bgkendall/Alufo/README.md

# Alufo

Small split keyboard using stacked one-layer aluminium core boards with an on-board CH552T controller.
