bgkendall/Alufo/Middle Layer/Alufo Middle Layer Left.stl

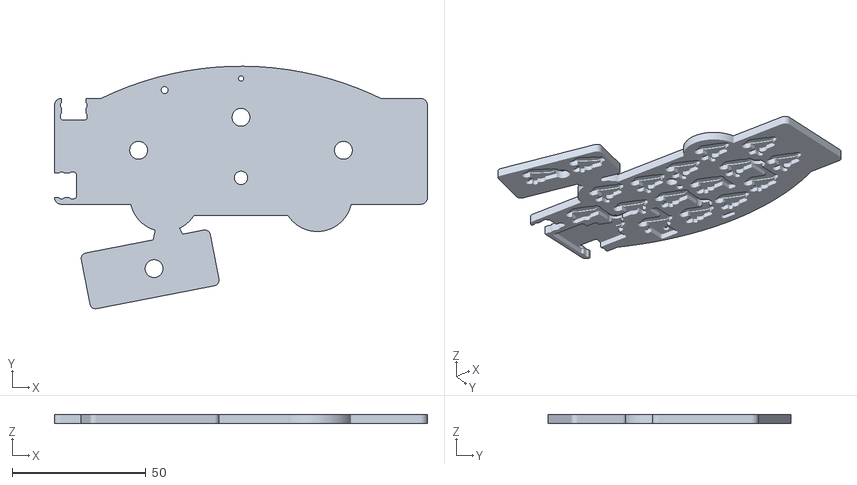
[picture p1: CAD file, 2024-11-10]
Middle Layer/Alufo Middle Layer Left.stl
139.7 x 90.9 x 3.50
