bgkendall/Alufo/(list of files, cad)

Other CAD files:
Middle Layer/Alufo Middle Layer Right.stl
