bgkendall/Alufo/PCB Left/Alufo.kicad_pcb

## KiCad design PCB Left/Alufo.kicad_pcb (2025-04-01)

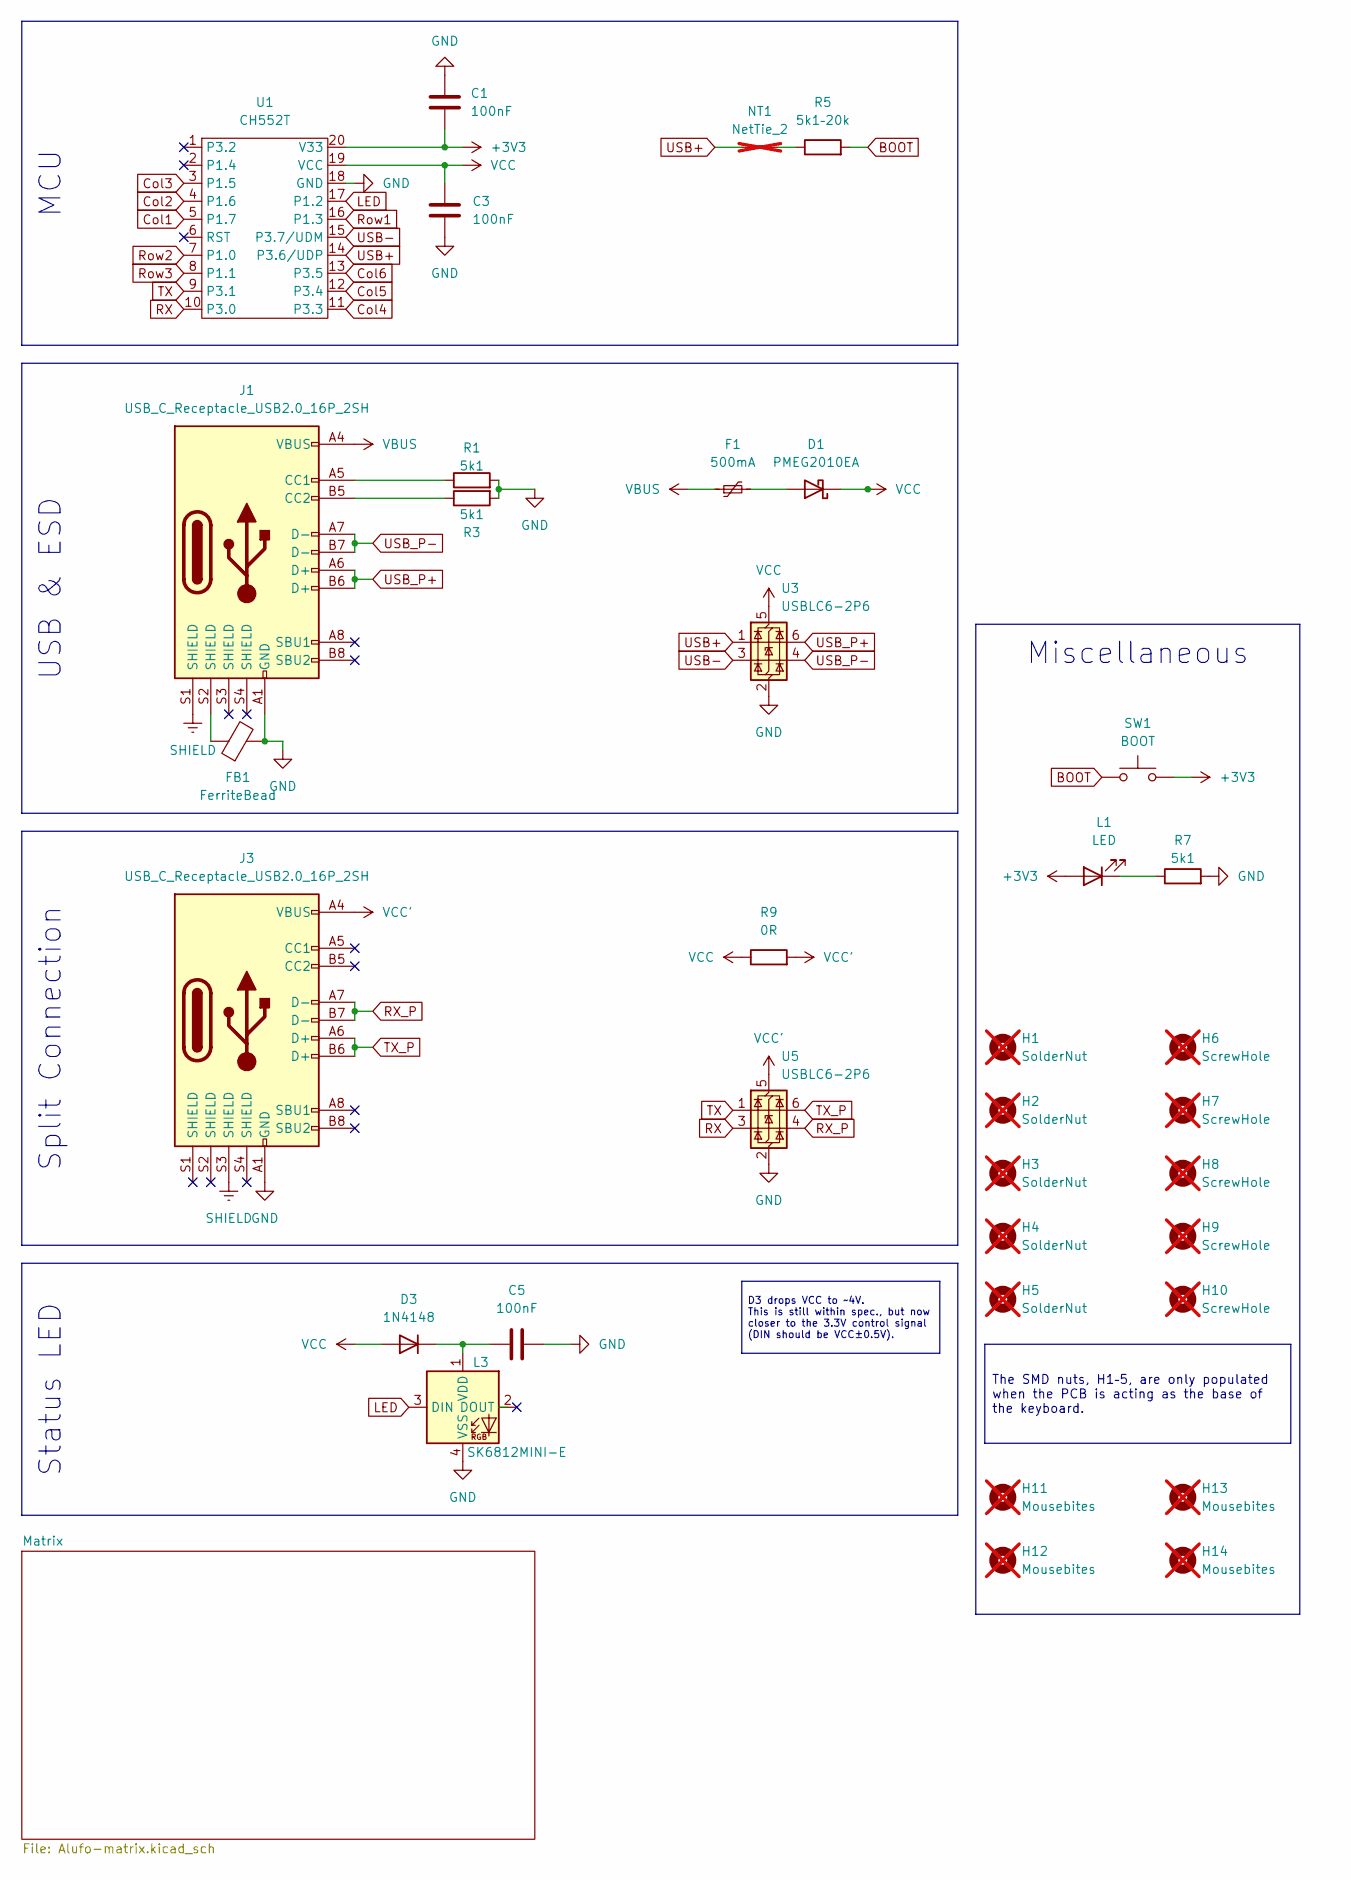
[picture p2: schematic Alufo.kicad_sch, Alufo]

Parts:
C1, C3, C5: 100nF; C_0603_1608Metric; LCSC C66501
D1: PMEG2010EA; D_SOD-323; LCSC C193668
D3: 1N4148; D_SOD-123; LCSC C917030
F1: 500mA; Fuse_0603_1608Metric; LCSC C210357
FB1: FerriteBead; L_0805_2012Metric; LCSC C20416196
H1, H2, H3, H4, H5: SolderNut; MountingHole_2.2mm_M2_SMD_Solder_Nut; not fitted
H6, H7, H8, H9, H10: ScrewHole; MountingHole_2.2mm_M2; not fitted
H11, H12, H13, H14: Mousebites; not fitted
J1, J3: USB_C_Receptacle_USB2.0_16P_2SH; USB_C_Receptacle_GCT_USB4110; LCSC C5143397
L1: LED; LED_0805_2012Metric_Mod; LCSC C965818
L3: SK6812MINI-E; LED_6028R; LCSC C5149201
NT1: NetTie_2; NetTie-2_SMD_Pad0.2mm; not fitted
R1, R3, R7: 5k1; R_0603_1608Metric; LCSC C23186
R5: 5k1–20k; R_0603_1608Metric; LCSC C25804
R9: 0R; R_2010_5025Metric; LCSC C2960848
SW1: BOOT; SW_SPST_SKQG_WithStem; LCSC C115351
U1: CH552T; TSSOP-20_4.4x6.5mm_P0.65mm; LCSC C111367
U3, U5: USBLC6-2P6; SOT-666_Mod; LCSC C3647099

Connections:
+3V3: C1.1, L1.2 (A), SW1.2, U1.20 (V33)
BOOT: R5.2, SW1.1
Col1: U1.5 (P1.7); also elsewhere on the board
Col2: U1.4 (P1.6); also elsewhere on the board
Col3: U1.3 (P1.5); also elsewhere on the board
Col4: U1.11 (P3.3); also elsewhere on the board
Col5: U1.12 (P3.4); also elsewhere on the board
Col6: U1.13 (P3.5); also elsewhere on the board
GND: C1.2, C3.2, C5.2, FB1.2, J1.A1 (GND), J1.A12 (GND), J1.B1 (GND), J1.B12 (GND), J3.A1 (GND), J3.A12 (GND), J3.B1 (GND), J3.B12 (GND), L3.4 (VSS), R1.2, R3.2, R7.2, U1.18 (GND), U3.2 (GND), U5.2 (GND)
LED: L3.3 (DIN), U1.17 (P1.2)
unnamed: D1.2 (A), F1.2
unnamed: C5.1, D3.1 (K), L3.1 (VDD)
unnamed: FB1.1, J1.S2 (SHIELD)
unnamed: J1.A5 (CC1), R1.1
unnamed: J1.B5 (CC2), R3.1
unnamed: L1.1 (K), R7.1
unnamed: NT1.2, R5.1
RX: U1.10 (P3.0), U5.3 (I/O2)
RX_P: J3.A7 (D-), J3.B7 (D-), U5.4 (I/O2)
Row1: U1.16 (P1.3); also elsewhere on the board
Row2: U1.7 (P1.0); also elsewhere on the board
Row3: U1.8 (P1.1); also elsewhere on the board
SHIELD: J1.S1 (SHIELD), J3.S3 (SHIELD)
TX: U1.9 (P3.1), U5.1 (I/O1)
TX_P: J3.A6 (D+), J3.B6 (D+), U5.6 (I/O1)
USB+: NT1.1, U1.14 (P3.6/UDP), U3.1 (I/O1)
USB-: U1.15 (P3.7/UDM), U3.3 (I/O2)
USB_P+: J1.A6 (D+), J1.B6 (D+), U3.6 (I/O1)
USB_P-: J1.A7 (D-), J1.B7 (D-), U3.4 (I/O2)
VBUS: F1.1, J1.A4 (VBUS), J1.A9 (VBUS), J1.B4 (VBUS), J1.B9 (VBUS)
VCC: C3.1, D1.1 (K), D3.2 (A), R9.1, U1.19 (VCC), U3.5 (VBUS)
VCC': J3.A4 (VBUS), J3.A9 (VBUS), J3.B4 (VBUS), J3.B9 (VBUS), R9.2, U5.5 (VBUS)

Notes on the sheet:
MCU
Miscellaneous
The SMD nuts, H1–5, are only populated when the PCB is acting as the base of the keyboard.
Split Connection
USB & ESD
D3 drops VCC to ~4V. This is still within spec., but now closer to the 3.3V control signal (DIN should be VCC±0.5V).
Status LED

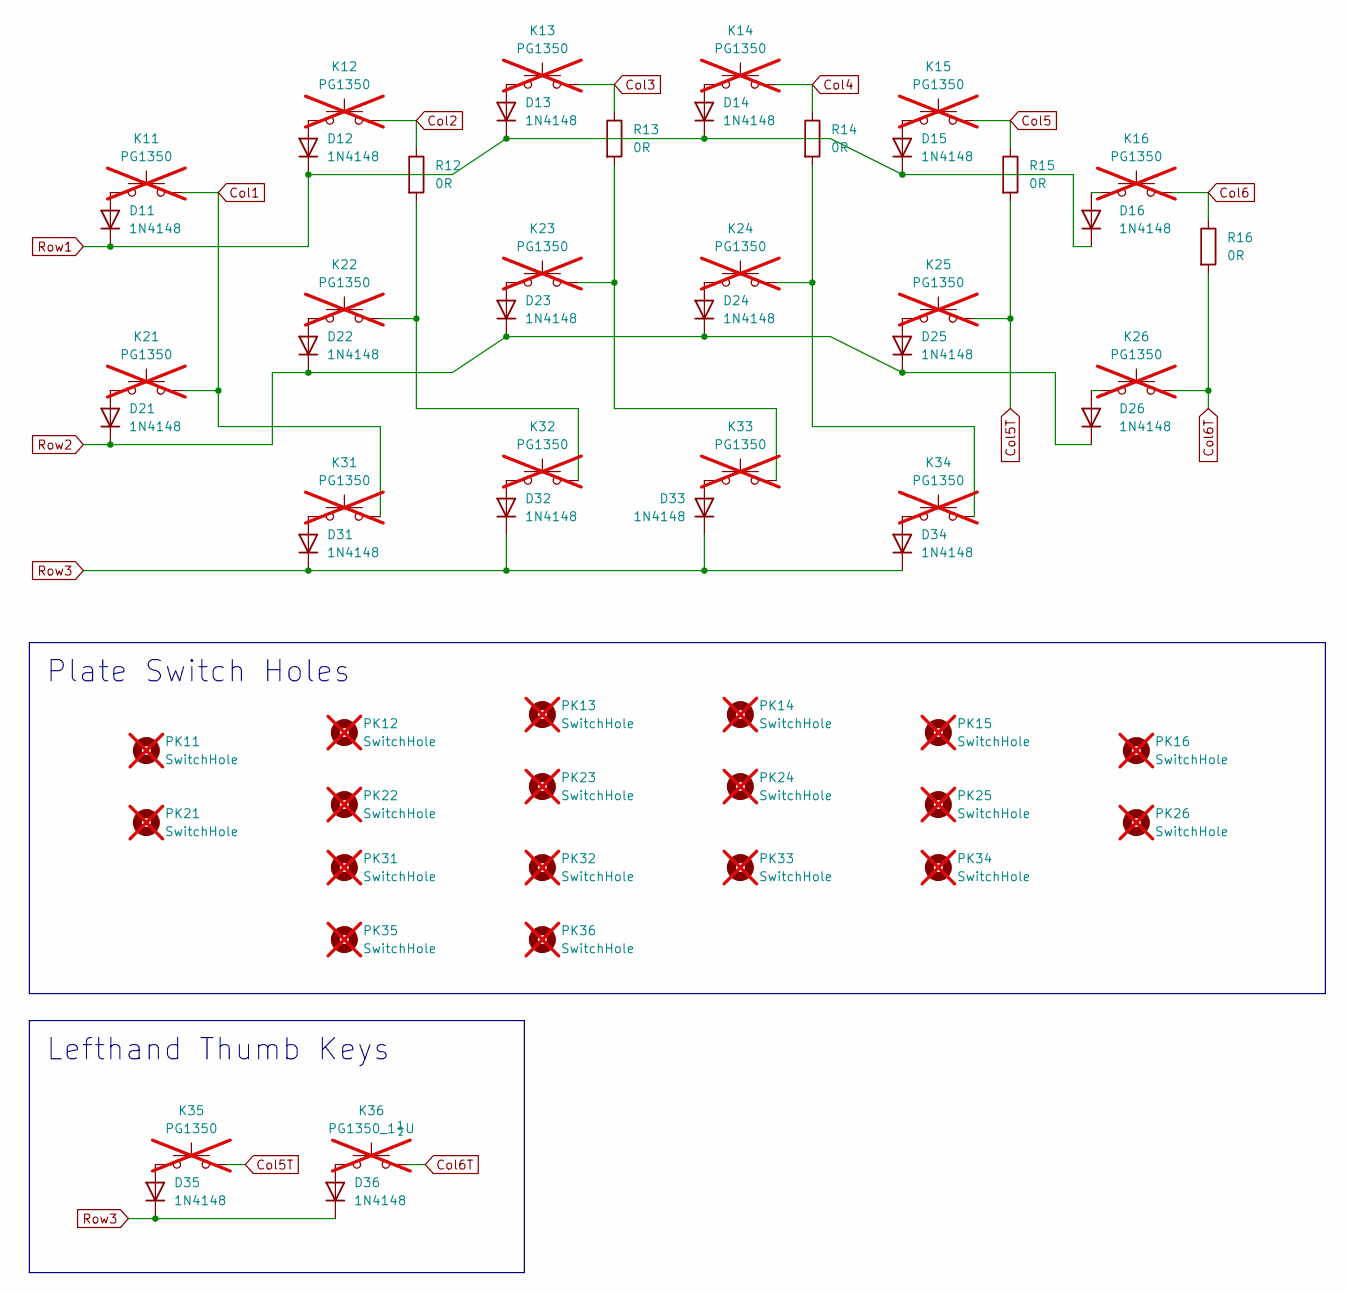
[picture p3: schematic Alufo-matrix.kicad_sch, Alufo]

Parts:
D11, D12, D13, D14, D15, D16, D21, D22, D23, D24, D25, D26, D31, D32, D33, D34, D35, D36: 1N4148; D_SOD-123_Mod; LCSC C917030
K11, K12, K13, K14, K15, K16, K21, K22, K23, K24, K25, K26, K31, K32, K33, K34, K35: PG1350; SW_choc_v1_HS_CPG135001S30_1layer_1u; LCSC C5333465; not fitted
K36: PG1350_1½U; SW_choc_v1_HS_CPG135001S30_1layer_1.5u; LCSC C5333465; not fitted
PK11, PK12, PK13, PK14, PK15, PK16, PK21, PK22, PK23, PK24, PK25, PK26, PK31, PK32, PK33, PK34, PK35: SwitchHole; SW_choc_v1_Plate_CPG135001S30_1u; not fitted
PK36: SwitchHole; SW_choc_v1_Plate_CPG135001S30_1.5u; not fitted
R12, R13, R14, R15, R16: 0R; R_2010_5025Metric; LCSC C2960848

Connections:
Col1: K11.1, K21.1, K31.1; also elsewhere on the board
Col2: K12.1, R12.1; also elsewhere on the board
Col3: K13.1, R13.1; also elsewhere on the board
Col4: K14.1, R14.1; also elsewhere on the board
Col5: K15.1, R15.1; also elsewhere on the board
Col5T: K25.1, K35.1, R15.2
Col6: K16.1, R16.1; also elsewhere on the board
Col6T: K26.1, K36.1, R16.2
unnamed: D11.2 (A), K11.2
unnamed: D12.2 (A), K12.2
unnamed: D13.2 (A), K13.2
unnamed: D14.2 (A), K14.2
unnamed: D15.2 (A), K15.2
unnamed: D16.2 (A), K16.2
unnamed: D21.2 (A), K21.2
unnamed: D22.2 (A), K22.2
unnamed: D23.2 (A), K23.2
unnamed: D24.2 (A), K24.2
unnamed: D25.2 (A), K25.2
unnamed: D26.2 (A), K26.2
unnamed: D31.2 (A), K31.2
unnamed: D32.2 (A), K32.2
unnamed: D33.2 (A), K33.2
unnamed: D34.2 (A), K34.2
unnamed: D35.2 (A), K35.2
unnamed: D36.2 (A), K36.2
unnamed: K22.1, K32.1, R12.2
unnamed: K23.1, K33.1, R13.2
unnamed: K24.1, K34.1, R14.2
Row1: D11.1 (K), D12.1 (K), D13.1 (K), D14.1 (K), D15.1 (K), D16.1 (K); also elsewhere on the board
Row2: D21.1 (K), D22.1 (K), D23.1 (K), D24.1 (K), D25.1 (K), D26.1 (K); also elsewhere on the board
Row3: D31.1 (K), D32.1 (K), D33.1 (K), D34.1 (K), D35.1 (K), D36.1 (K); also elsewhere on the board

Notes on the sheet:
Lefthand Thumb Keys
Plate Switch Holes

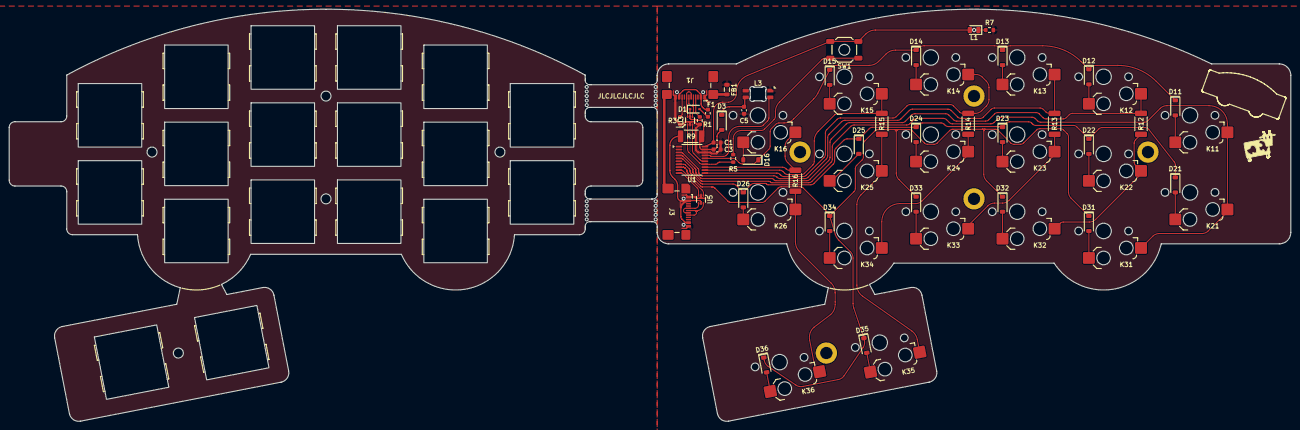
[picture p4: board Alufo.kicad_pcb from above]

Board: 2 copper layers, 282.6 x 90.9 mm, 94 parts (0 on the bottom side), 55 nets.
