bgkendall/Alufo/(commit log)

2024-07-21 Add initial version
    Very rough routing of matrix
    No USB ports, etc.
    [alumirror.kicad_pcb, alumirror.kicad_sch]
2024-07-21 Add possible deboss area for 3D print to switches
    Move top row diodes within this area
    Remove copper layers from switch pin holes
    [alumirror.kicad_pcb]
2024-07-21 Add 3D model pocket areas for all matrix components
    User 1–4 layers of switches, diodes and resistors now contain areas that will be excluded from the 3D print for the bottom-mid case. This will allow space for these components. These areas are constructed from shapes (e.g., the diode has two circles with a connecting rectangle) rather than lines. This is so that they can be imported straight into FreeCAD. Using arcs and lines would look cleaner, but the exported SVG files would need to be modified in design software to merge each group of lines into a single shape before import into FreeCAD.
    [alumirror.kicad_pcb, alumirror.kicad_sch]
2024-07-21 Tighten diode pocket
    [alumirror.kicad_pcb]
2024-07-22 Tweak edge cuts
    Also add keycap outlines to back silkscreen so they can be seen when viewing the 3D board model.
    [alumirror.kicad_pcb]
2024-07-22 Re-work thumb key connections
    The lefthand thumb keys are now on row 2, columns 0 and 5. This frees up a pin for potential red, green *and blue* LEDs.
    The righthand thumb keys remain on their own row. This is easier to route and allows for a 5-way navigation switch to be added.
    [alumirror.kicad_pcb, alumirror.kicad_sch]
2024-07-25 Add nav. switch proof-of-concept
    [alumirror.kicad_pcb, alumirror.kicad_sch]
2024-07-27 Add 3D model for SKQUAAA010
    The board actually uses a SKQUCAA010, but this is close enough
    Model from https://www.snapeda.com/parts/SKQUAAA010/ALPS/view-part/
    [alumirror.kicad_pcb]
2024-07-27 Renumber switches and diode by row and column
    [alumirror.kicad_pcb, alumirror.kicad_sch]
2024-07-27 Create combined choc/nav. switch footprint and use for SW31
    [alumirror.kicad_pcb, alumirror.kicad_sch]
2024-07-27 Add missing middle case layer cutout section for switches
2024-07-27 Flop board
    Switches now go in the correct column order (right to left when viewed from the copper side of the PCB) and the navigation switch is on the right thumb.
    [alumirror.kicad_pcb, alumirror.kicad_sch]
2024-07-27 Switch to SKQUAAA010 3D model that is not in lurid colours
    Model from https://componentsearchengine.com/part-view/SKQUAAA010/ALPS%20Electric
    [alumirror.kicad_pcb]
2024-07-27 Move bottom row one column over
    This allows the left thumb keys to be on adjacent columns and saves routing Column 0 all the way across the board.
    [alumirror.kicad_pcb, alumirror.kicad_sch]
2024-07-27 Tidy routing
    [alumirror.kicad_pcb]
2024-07-27 Tidy schematic
    [alumirror.kicad_pcb, alumirror.kicad_sch]
2024-07-28 Add lefthand USB, ESD, etc. components to schematic
    [alumirror.kicad_sch]
2024-07-28 Add lefthand active components to PCB and route
    [alumirror.kicad_pcb, alumirror.kicad_sch]
2024-07-28 Renamed all key switches to K##
    [alumirror.kicad_pcb, alumirror.kicad_sch]
2024-07-29 Add LEDs
    [alumirror.kicad_pcb, alumirror.kicad_sch]
2024-07-29 Use smaller (0603) power LED
    [alumirror.kicad_pcb, alumirror.kicad_sch]
2024-07-30 Add 0603 LED footprint with holes and 3D model cutouts
    The drill holes will allow the LED to be visible through the PCB that will act as the base.
2024-07-30 Add 0603 resistor footprint with 3D model cutout
2024-07-30 Add 3D model cutout to SKQG switch footprint
    More than just the boot hole pass-through!
2024-07-30 Tweak silkscreen of combined choc/nav switch footprint
2024-07-30 Move power LED to middle of PCB above boot switch
    Plus various routing tweaks and footprint updates.
    [alumirror.kicad_pcb, alumirror.kicad_sch]
2024-07-31 Add righthand active components
    Routing is **very** rough
    [alumirror.kicad_pcb, alumirror.kicad_sch]
2024-07-31 Tidy schematic
    Matrix is broken out into a separate sheet
    Controller components are more organised
    [alumirror-matrix.kicad_sch, alumirror.kicad_pcb, alumirror.kicad_sch]
2024-07-31 Relocate lefthand capacitors
    [alumirror.kicad_pcb]
2024-07-31 Rearrange components for better layout
    [alumirror.kicad_pcb, alumirror.kicad_sch]
2024-07-31 Rotate D31–35 90º
    [alumirror.kicad_pcb]
2024-08-02 Convert 3D model cutout outlines to polygons
    This gives more flexibility to the shapes and is less clutter on the board.
    [alumirror.kicad_pcb]
2024-08-04 Replace three-colour RGB LED with SK6812MINI-E
    [alumirror.kicad_pcb, alumirror.kicad_sch]
2024-08-04 Add custom SOT-666 footprint
    Footprint has ground routing and 3D cutout
    [alumirror.kicad_pcb, alumirror.kicad_sch]
2024-08-04 Fix USBLC6’s silkscreen locations
    [alumirror.kicad_pcb]
2024-08-05 Refine middle layer 3D print cutouts
    Also renumber diodes — D0# are now DO# and SD1 and SD2 are and D2
    Add diode (D3) on VCC line to RGB LED (this drops VCC to ~4V, which is still within spec., but now closer to the 3.3V control signal as DIN should be VCC±0.5V).
    [alumirror-matrix.kicad_sch, alumirror.kicad_pcb, alumirror.kicad_sch]
2024-08-06 Rotate thumb keys and set outline
    Thumb keys rotated by 11° and lined up
    Margin around thumb keys is ⅛ vertical U (2.125mm)
    [alumirror.kicad_pcb]
2024-08-06 Switch RGB LED capacitor (C5) and resistor (R15) to 0805 size
    Found some 0805 470Ω resistors in the parts bin, and this size is a bit less ridiculously small than 0603.
    Also, switched LED pin to P1.3 for better spacing and fixed (now) unnecessary misalignment of R13.
    [alumirror.kicad_pcb, alumirror.kicad_sch]
2024-08-06 Add footprint for solder nuts
    3.5mm high M2 solder nuts will be used between the PCB that will act as the base of the board and the active PCB. They will not be soldered with any other components.
2024-08-06 Add mounting holes and re-route tracks around them
    [alumirror.kicad_pcb, alumirror.kicad_sch]
2024-08-07 Create another custom SOD-123 footprint
    This one has the thicker polarity line of the existing modification, but without the 3D layer cutout.
    [alumirror-matrix.kicad_sch, alumirror.kicad_pcb, alumirror.kicad_sch]
2024-08-08 Change RGB LED decoupling capacitor (C5)
    Use 100nF — there seems to be some contradictory information on this, but this seems to be the consensus.
    Use 0603 size since the capacitance now matches C1–4, which are this size.
    [alumirror.kicad_pcb, alumirror.kicad_sch]
2024-08-08 Change power LED to larger 0805 size
    Hopefully slightly less fiddly…
    [alumirror.kicad_pcb, alumirror.kicad_sch]
2024-08-10 Adjust component locations
    [alumirror.kicad_pcb, alumirror.kicad_sch]
2024-08-10 Add identifying text to PCB
    [alumirror-matrix.kicad_sch, alumirror.kicad_pcb, alumirror.kicad_sch]
2024-08-10 Change project name to Title Case
    [alumirror-matrix.kicad_sch, alumirror.kicad_pcb, alumirror.kicad_sch]
2024-08-10 Change file names to Title Case
    [Alumirror-matrix.kicad_sch, Alumirror.kicad_pcb, Alumirror.kicad_sch]
2024-08-11 Clean up edges around thumb keys
    [Alumirror.kicad_pcb]
2024-08-11 Switch R14 back to 2010 size
    [Alumirror.kicad_pcb, Alumirror.kicad_sch]
2024-08-11 Shuffle components around again and fix DRC messages
    * Move split connection ESD chip to inside of associated USB port instead of above.
    * Scootch MCUs down.
    * Reduce clearance of ESD chip ground pin polygon pad.
    * Change solder nut hole to through-hole pad instead of NPT hole and solid pad.
    [Alumirror.kicad_pcb, Alumirror.kicad_sch]
2024-08-12 Renumber components
    * For single-digit components:
    * Odd numbers are populated on the lefthand board only
    * Even numbers are populated on the righthand board only
    * Double-digit components are populated on both sides
    [Alumirror-matrix.kicad_sch, Alumirror.kicad_pcb, Alumirror.kicad_sch]
2024-08-12 Renumber matrix switches and diodes
    Columns and rows start from 1 rather than 0.
    All components now follow the rules from the previous change, and we don’t had to mess around with the fake D-“oh” nonsense.
    [Alumirror-matrix.kicad_sch, Alumirror.kicad_pcb, Alumirror.kicad_sch]
2024-08-12 Update resistor values
    Testing seemed to show that 5.1KΩ will work well for a dim power LED.
    The value for the boot resistor is not well defined, but values from 5.1KΩ to 20KΩ have been seem.
    (Using 5.1KΩ for these means that the same resistor stock used for USB power control can be used.)
    [Alumirror.kicad_pcb, Alumirror.kicad_sch]
2024-08-12 Start to clean up traces
    [Alumirror.kicad_pcb]
2024-08-14 Clean up cross-board column routing
    [Alumirror.kicad_pcb, Alumirror.kicad_sch]
2024-08-14 Remove ground fill from thumb areas
    [Alumirror.kicad_pcb]
2024-08-14 Clean up left thumb traces
    [Alumirror.kicad_pcb]
2024-08-16 Switch label to mask instead of silkscreen
    [Alumirror.kicad_pcb]
2024-09-15 Switch K22 to new “clipped” footprint
    Clipped footprint has a cut-out in one of the hot-swap socket pads to avoid proximity warning with solder nut pad.
    Also tweaked and rounded multiple traces.
    [Alumirror-matrix.kicad_sch, Alumirror.kicad_pcb]
2024-09-22 Add back explicit GND trace and tweak some silkscreen items
    [Alumirror.kicad_pcb]
2024-09-23 Remove need for clipped hot-swap footprint
    Moved mounting holes up 1/48U allowing K22 to be a regular socket. The mounting hole should still not interfere with the surrounding switches.
    [Alumirror-matrix.kicad_sch, Alumirror.kicad_pcb]
2024-09-26 Change project name from Alumirror to Alufo
    Since it is likely that the left and right hand PCBs will be split, there won’t actually be much mirroring going on (also most split keyboards are mirrored left to right, so that not particularly special or unique!). Instead the name will emphasise the slight flying saucer look of the PCB with Al(uminium) + UFO = Alufo.
    [Alufo-matrix.kicad_sch, Alufo.kicad_pcb, Alufo.kicad_sch]
2024-09-26 Create separate projects for left and right hands
    [Alufo-matrix.kicad_sch, Alufo.kicad_pcb, Alufo.kicad_sch]
2024-09-26 Remove righthand components from lefthand board
    [Alufo-matrix.kicad_sch, Alufo.kicad_pcb, Alufo.kicad_sch]
2024-09-26 Remove lefthand components from righthand board
    [Alufo-matrix.kicad_sch, Alufo.kicad_pcb, Alufo.kicad_sch]
2024-09-26 Refine outline of boards
    [Alufo.kicad_pcb]
2024-09-26 Clean-up left/righthand schematics
    [Alufo.kicad_sch]
2024-09-26 Remove status LED resistor
    [Alufo.kicad_pcb, Alufo.kicad_sch]
2024-09-27 Update logo and add to PCB
    Logo now has PCB revision included and is positioned at top left/right edge ±1.25,+1.25mm.
    Author is now positioned between lowest row 2 pad 2 and bottom edge, centred to logo.
    [Alufo.kicad_pcb]
2024-09-27 Realign columns on righthand side
    [Alufo-matrix.kicad_sch, Alufo.kicad_pcb]
2024-09-27 Remove unneeded R16 from righthand side
    [Alufo-matrix.kicad_sch, Alufo.kicad_pcb]
2024-09-27 Route Row 2 under upper 0Ω resistors
    TODO: Reconnect Column 6 to thumb row
    [Alufo-matrix.kicad_sch, Alufo.kicad_pcb, Alufo.kicad_sch]
2024-09-27 Route Row 3 under upper 0Ω resistors and remove lower 0Ω resistors
    [Alufo-matrix.kicad_sch, Alufo.kicad_pcb]
2024-09-27 Relocate diodes
    [Alufo.kicad_pcb]
2024-09-27 Tweak D26 location
    [Alufo.kicad_pcb]
2024-09-27 Align upper 0Ω resistors as on righthand, remove R11
    [Alufo-matrix.kicad_sch, Alufo.kicad_pcb]
2024-09-27 Route Row 2 under upper 0Ω resistors
    [Alufo.kicad_pcb]
2024-09-27 Route Row 3 under upper 0Ω resistors
    [Alufo.kicad_pcb]
2024-09-27 Remove lower 0Ω resistors
    [Alufo-matrix.kicad_sch, Alufo.kicad_pcb]
2024-09-27 Remove “L” from column labels
    [Alufo-matrix.kicad_sch, Alufo.kicad_pcb, Alufo.kicad_sch]
2024-09-27 Remove “L” and “R” from all labels
    [Alufo.kicad_pcb, Alufo.kicad_sch]
2024-09-27 Renumber previously common components
    [Alufo.kicad_pcb, Alufo.kicad_sch]
2024-09-27 Add silkscreen to show board curve on thumb cluster connector
    (In case someone wanted to remove either or both of the thumb clusters.)
    [Alufo.kicad_pcb]
2024-09-30 Manually add cutouts for 2010 resistors
    Using middle-layer cutouts defined in the footprint no longer works as the resistors are now vertically aligned in relation to each rather than a set distance from the switch sockets.
    [Alufo-matrix.kicad_sch, Alufo.kicad_pcb]
2024-09-30 Clean up routing through jumper resistors
    [Alufo.kicad_pcb]
2024-09-30 Align R16 with socket pads
    [Alufo.kicad_pcb]
2024-10-02 Move boot switch and tweak location of power LED
    Boot switch is now closer to the MCU, roughly where the LED would be on the switches K15 (lefthand) or K12 (righthand). The power LED is now a little further away from the top edge.
    [Alufo.kicad_pcb]
2024-10-02 Clean up routing of right thumb keys
    [Alufo.kicad_pcb]
2024-10-20 Clean-up traces on lefthand board
    [Alufo.kicad_pcb]
2024-10-20 Clean-up traces on righthand board
    Also make tweaks to lefthand
    [Alufo.kicad_pcb]
2024-10-20 Minor tweaks
    [Alufo.kicad_pcb]
2024-10-21 Further routing tweaks
    [Alufo.kicad_pcb]
2024-10-21 Add fun logo on lefthand board
    [Alufo.kicad_pcb]
2024-10-21 Power routing tweaks
    [Alufo.kicad_pcb]
2024-10-21 Fix boot access hole location
    Because the lefthand side PCB will become the base for the righthand board (and vice versa), and because the boot button is no longer centred, the hole in the base to allow access to the button must be on the opposite side of the centreline to that button. This means the access hole needs to be a separate component and the boot switch footprint no longer needs a central hole.
    [Alufo.kicad_pcb, Alufo.kicad_sch]
2024-10-22 Update schematic revision
    [Alufo-matrix.kicad_sch, Alufo.kicad_sch]
2024-10-22 Update lefthand title block and dynamic text
    [Alufo.kicad_pcb]
2024-10-22 Add “crop circle” image to righthand side, update title block and dynamic text
    [Alufo.kicad_pcb]
2024-10-22 Revert boot access hole change
    It was correct before!
    [Alufo.kicad_pcb, Alufo.kicad_sch]
2024-10-22 Fix alignment of thumb cluster screw hole
    It did not line up when one side’s PCB was used as a base for the other.
    [Alufo.kicad_pcb]
2024-10-24 Add lefthand plate
    The plate file is arranged to the left of the main PCB. This arrangement is a little more costly than if the plate were upside down under the PCB. However, the cost difference is small (~$3 for a five-PCB run) and this way makes it easier to crosscheck and make matching adjustments to the plate and the PCB.
    [Alufo-matrix.kicad_sch, Alufo.kicad_pcb, Alufo.kicad_sch]
2024-10-24 Add order number location
    [Alufo.kicad_pcb]
2024-10-24 Update plate outline
    [Alufo.kicad_pcb]
2024-10-26 Move thumb clusters down 2mm
    [Alufo.kicad_pcb]
2024-10-26 Add plate to righthand board
    [Alufo-matrix.kicad_sch, Alufo.kicad_pcb, Alufo.kicad_sch]
2024-10-28 Connect aluminium back to copper layer
    Holes J5 and J6 will be filled with solder on the active PCB to connect the back aluminium layer (which is connected to the USB shield) with the mounting hole H3. H3 will in turn connect to the bottom layer PCB via the solder nut pressed against the exposed pad on the active PCB. The solder nut will connect to the screw and the screw will connect to the top plate. The upper middle plate will connect to the shield by virtue of being physically pressed to the active PCB’s back (if correctly oriented).
    [Alufo.kicad_pcb, Alufo.kicad_sch]
2024-11-01 Do not exclude solder nuts from BOM
    [Alufo.kicad_pcb, Alufo.kicad_sch]
2024-11-02 Update link between PCB and plate
    There are now two connections, with mouse bites at both ends.
    [Alufo.kicad_pcb, Alufo.kicad_sch]
2024-11-08 Rename PCB directories
    [Alufo-matrix.kicad_sch, Alufo.kicad_pcb, Alufo.kicad_sch]
2024-11-08 Remove 3D model from plate switch holes
    Also add connecting edge line on plate side of PCB to User.Drawings.
    [Alufo.kicad_pcb]
2024-11-08 Clip leftmost socket pad on thumb row
    The middle layer wall should now be ~1.5mm thick next to that pad instead of just ½mm.
    [Alufo.kicad_pcb]
2024-11-08 Round 0Ω resistor cutouts that do not end in a switch cutout
    [Alufo.kicad_pcb]
2024-11-08 Expand cutout for boot switch to avoid slender wall
    [Alufo.kicad_pcb]
2024-11-08 Increase cutouts for solder nuts to avoid thin walls
    The cutouts now merge with adjacent switch cutouts rather than leaving a very thin gap.
    The solder nut that connects to the shield is a separate footprint that does not need to be expanded.
    [Alufo.kicad_pcb]
2024-11-08 Reduce size of cutout for USB ports
    [Alufo.kicad_pcb]
2024-11-08 Further increase size of solder nut cutout
    Decrease size of right thumb diode cutout to prevent a thin wall between it and the larger solder nut cutout.
    [Alufo.kicad_pcb]
2024-11-09 Tweak track routing after final review
    Also:
    * Move diodes D16 and D26 on righthand PCB to other side of switch centre to improve routing of Col 6 trace.
    * Move JLC identifier location to connecting panels that will be discarded.
    * Prepare for fabrication.
    [Alufo.kicad_pcb]
2024-11-09 Add Gerber archives
    [Alufo.kicad_pcb]
2024-11-09 Set minimum hole size to 0.65mm
    This is the minimum hole size JLC can support on aluminium boards.
    The following changes were made:
    * Power LED now has a single 0.7mm hole instead of three 0.3mm ones. (This is for the light to shine through the PCB that will act as the base.)
    * Mouse-bite holes changed from 0.5mm to 0.65mm and moved accordingly.
    * USB port leg holes *and pads* now 0.05mm wider.
    Also smoothed out ground plane connection on ESD chips. (Now uses arcs instead of a trapezoid pad.)
    [Alufo.kicad_pcb]
2024-11-09 Tweak cutout outlines to prevent thin walls and islands
    [Alufo.kicad_pcb]
2024-11-10 Update middle layer cutouts
    There was no need for separate heights for the diodes and switch legs as it turned out to be only 0.1mm difference between them.
    To apply this and take advantage of the default KiCad colours the following changes were made:
    * User.1 (2010 resistors) moved to User.2
    * User.2 (diodes) merged into User.3
    * User.6 (100% holes) moved to User.9
    [Alufo.kicad_pcb]
2024-11-10 Add middle layer model design
    The SVGs exported from KiCad have been included even though they are transient files.
2024-11-10 Add cutout in middle layer for solder jump
    [Alufo.kicad_pcb, Alufo.kicad_sch]
2024-11-10 Add middle layer 3D model design and STLs
    [Alufo Middle Layer Left.stl, Alufo Middle Layer Right.stl]
2024-12-12 Add LCSC part numbers to left side
    [Alufo-matrix.kicad_sch, Alufo.kicad_pcb, Alufo.kicad_sch]
2025-04-01 Update project library name in schematic
    [Alufo-matrix.kicad_sch]
2025-04-01 Update to KiCad v9
    [Alufo-matrix.kicad_sch, Alufo.kicad_pcb, Alufo.kicad_sch]
2025-04-01 Further library name corrections in schematic; update PCB
    [Alufo.kicad_pcb, Alufo.kicad_sch]
2025-04-01 Switch to SMD USB ports
    [Alufo-matrix.kicad_sch, Alufo.kicad_pcb, Alufo.kicad_sch]
2025-04-01 Correct LCSC part number for USB port
    Reviewed all other parts
    [Alufo.kicad_sch]
2025-04-01 Update right side
    Also add outline for middle layer to new USB port footprint (although it won’t be right.
    [Alufo-matrix.kicad_sch, Alufo.kicad_pcb, Alufo.kicad_sch]
